wagiminator/ATtiny13-ContinuityTester/hardware/ContinuityTester_BOM.tsv

ID | Name | Designator | Footprint | Quantity | Manufacturer Part | Manufacturer | Supplier | Supplier Part | LCSC Assembly
1 | MLT-5030 | BUZZER | MLT-5030 | 1 | MLT-5030 | HNDZ | LCSC | C95297
2 | 51R | R1 | 0603 | 1 | 0603WAF510JT5E | UniOhm | LCSC | C23197
3 | 1k5 | R2 | 0603 | 1 | 0603WAF1501T5E | UniOhm | LCSC | C22843
4 | PWR | LED1 | LED0603 | 1 | KT-0603R | KENTO | LCSC | C2286 | Yes
5 | GND | H2 | HDR-M-2.54_1X1 | 1 |  |  | LCSC | C81276
6 | 100n | C1 | 0603 | 1 | CC0603KRX7R9BB104 | YAGEO | LCSC | C14663
7 | POGO | H1 | POGO | 1
8 | LIR1220 | B1 | CR1220-SMD | 1
9 | ATTINY13A-SSU | U1 | SOP-8_150MIL | 1 | ATTINY13A-SSU | MICROCHIP | LCSC | C14075
