wagiminator/ATtiny13-ContinuityTester/hardware/ContinuityTester_schematic.pdf

## Microcontroller

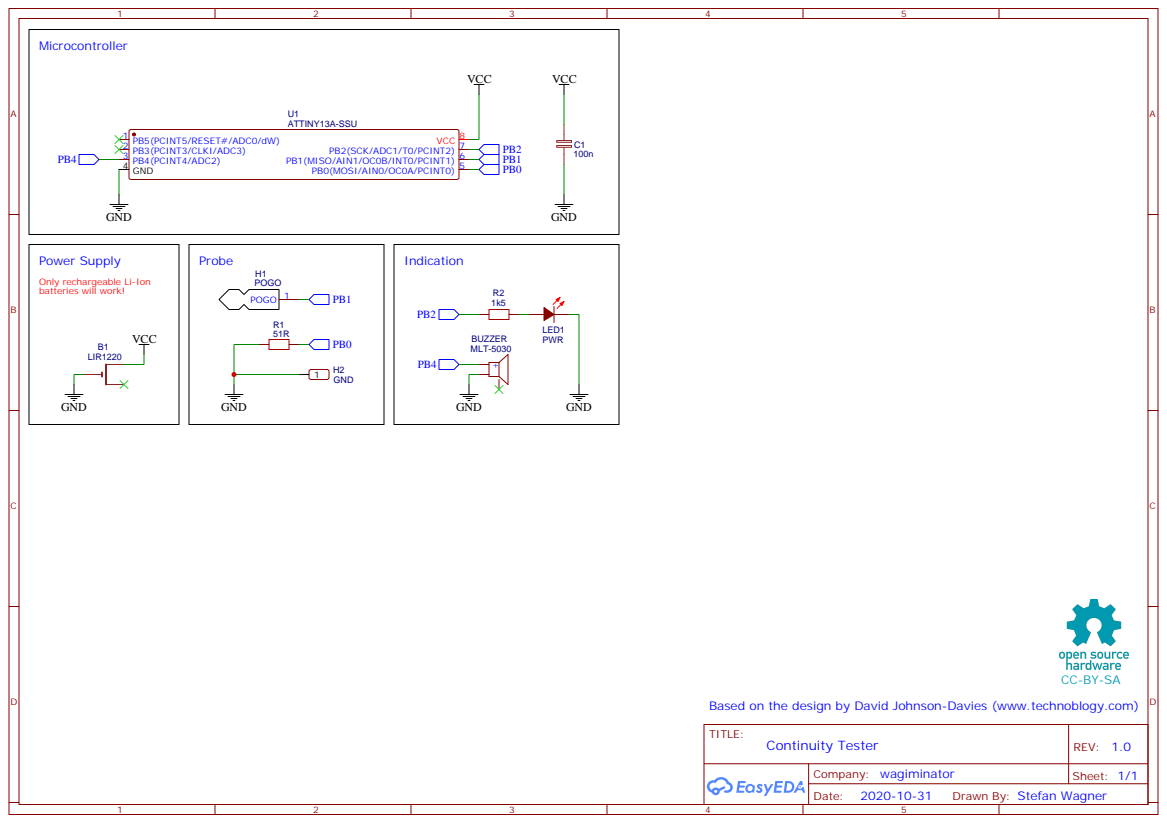
[picture p6: page 1]

Only rechargeable Li-Ion
batteries will work!

Based on the design by David Johnson-Davies (www.technoblogy.com)

Drawn By: Stefan Wagner
