wagiminator/ATtiny13-ContinuityTester/(commit log)

2020-12-14 Update files
    [ContinuityTester_BOM.tsv]
2022-04-29 Make the buzzer sound better.
    * disable pin change interrupts when waking up and enable
    it before sleeping for stabling the buzz frequency.
    * turn off the buzzer after a short period for debouncing.
    [ContinuityTester.ino]
2022-07-07 Make the buzzer sound better
    [ContinuityTester.ino]
